zaelu/ZaeLinK/ZaeLinK description.md

# This is the Zaelink VR Gunstock

First pictures shows it in Quest 3 Configuration, Detachable Buttstock  and adjustable in length connecting rods (Olympic version). No Buttstock and Fixed Buttstock versions are also available (details bellow). 

### Left side view:

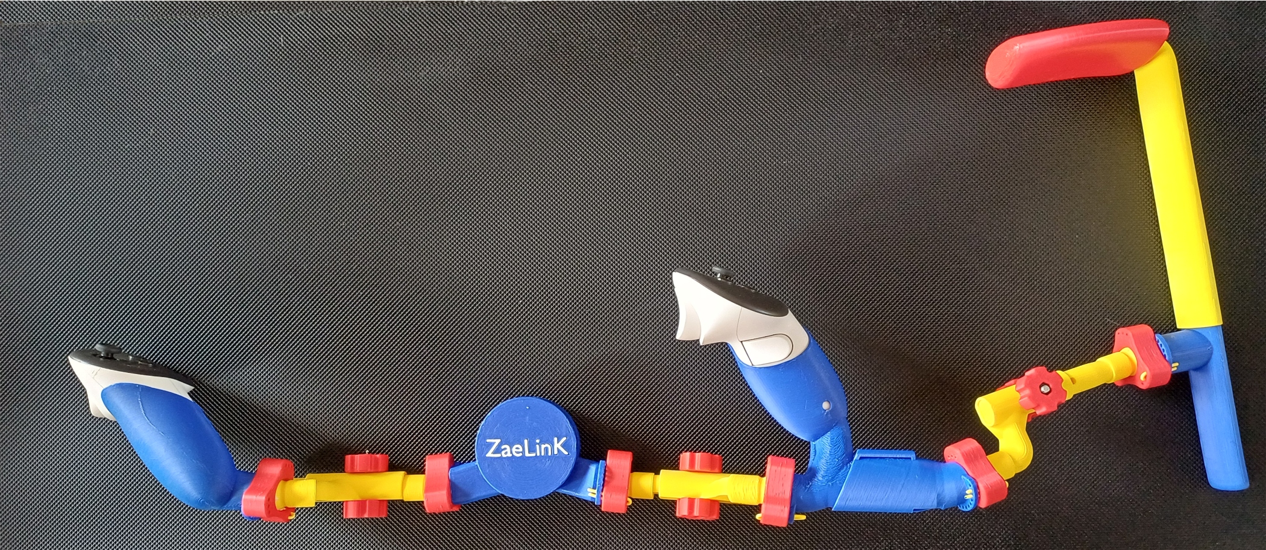
[picture p2: photos_docs/poza001.jpg]
Left side view


### Top down view:

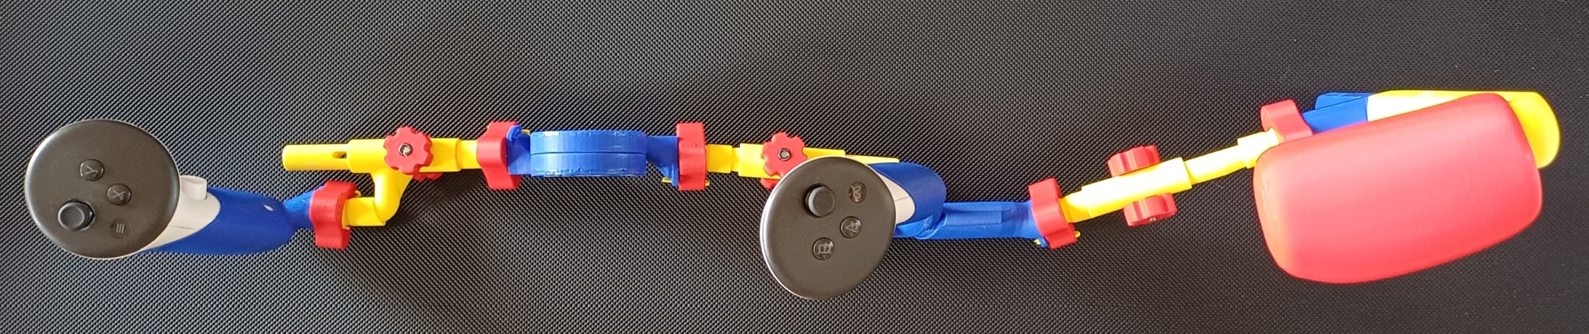
[picture p3: photos_docs/poza002.jpg]
Top down view


### Right side view:

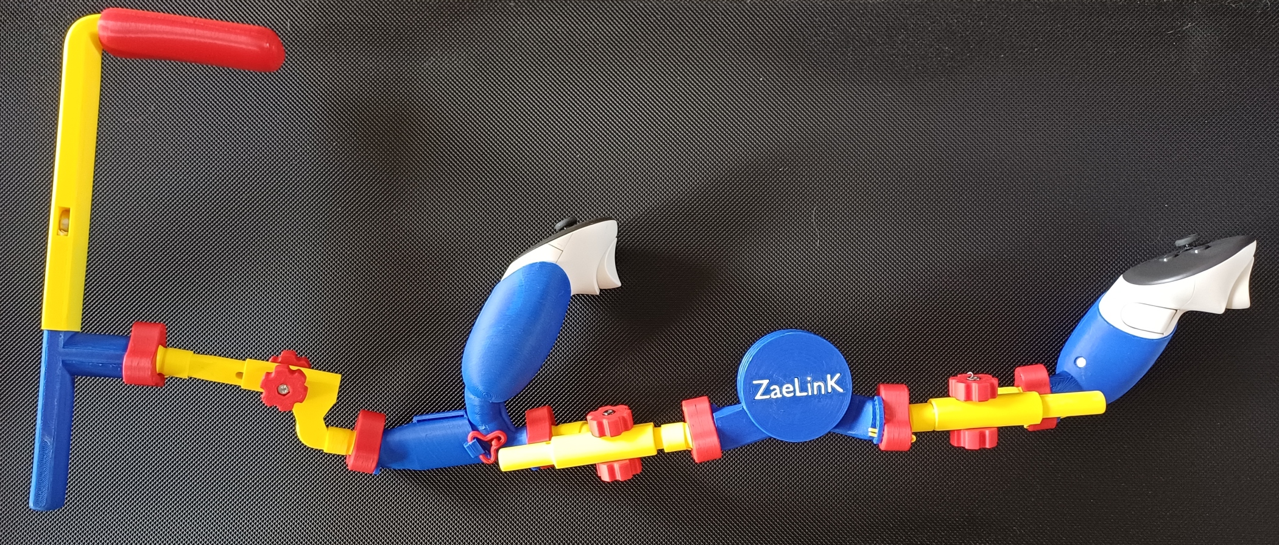
[picture p4: photos_docs/poza003.jpg]
Right side view

  
In this next two pictures we have the gunstock disassembled in its main component parts (NOTE that Quest 3s, Quest Pro and Quest 2 use the same cups as Quest 3) :  

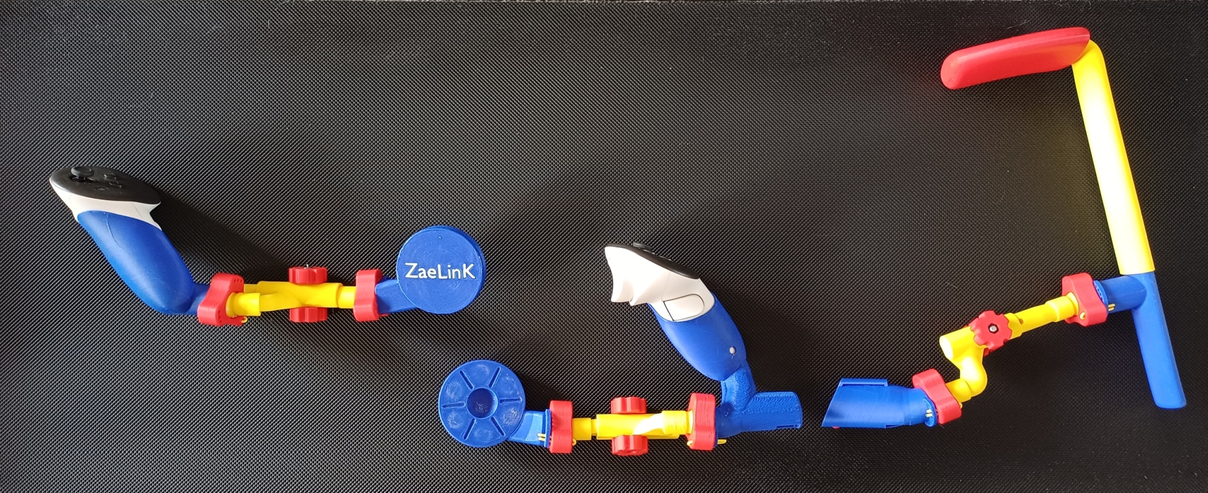
[picture p5: photos_docs/poza004.jpg]
main components


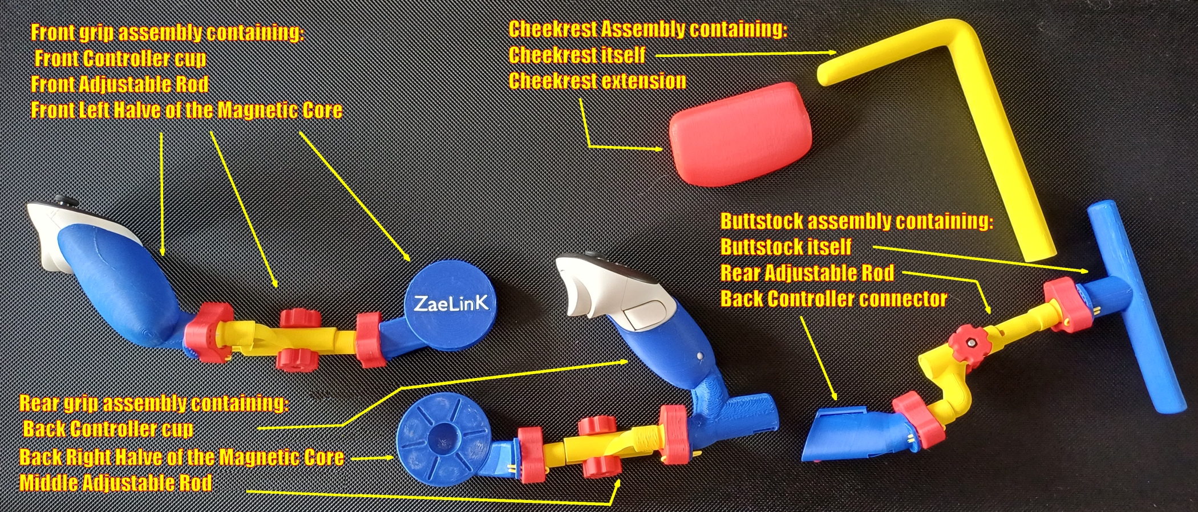
[picture p6: photos_docs/poza006.jpg]
main components2

  
The components of the Zaelink VR Gunstock are:  
  
**1** The main component is the **Magnetic Core** that effectively makes the connection between the two VR motion controllers user operates in realistic VR shooter type games or experiences.  

This Core is comprised of two round halves connected via connecting rods to the VR Touch Controllers. Inside the two circular halves that resembles to very flat cilinders facing each other vertically there are a pattern of (usually) 6 (six) button type magnets (15x6mm or smaller thickness for adjusting magnetic power) arranged in a hexagonal pattern where each center of every magnet finds itself on a corner of this hexagonal imaginary shape that defines its pattern. The distance between magnets can also be tweaked but the Zaelink VR Gunstock uses a fixed 5cm length for any hexagon edge as it was found to be optimal for this application.  
The two halves of the Magnetic Core thus attract each other by magnetic means while in close proximity aligning themselves with each of the six magnets of one side snapping to each of the six magnets of e other side. 

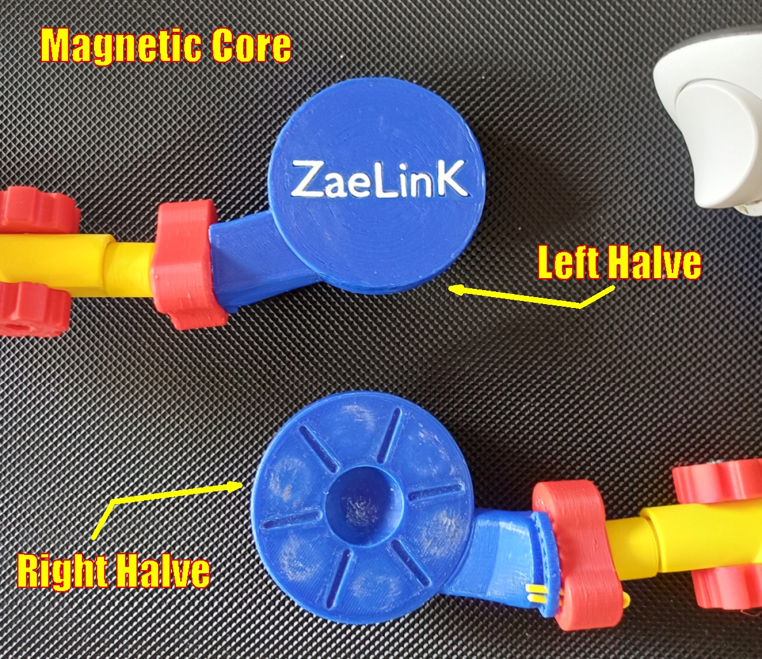
[picture p7: photos_docs/poza007.jpg]
Core pic 1


There are two principal patterns that are used:

 **FRAGNETTO**
 mode where 6 magnets on one side all aligned in polarity in same direction face the opposite polarity of the 6 magnets of the other side also all aligned in polarity in same direction as described also above. This pattern allows for strong attraction and auto orientation and alignment in most cases and also a good connection. After the connection was done the two halves can be rotated one in relation to the other by 60° steps at least twice in each direction (six steps in total for 360° but practically maximum 3 can be done before mechanical limits stop any rotation or force disconnection). After each rotation step the connection will stay ON being only weakened during translation. This weakening moment in translation is also a moment that can be exploited by the user to quickly disconnect the two halves by rotating them and as the rotation step is half way pulling the two halves apart. The disconnection can be done also by a more firm longitudinal twist and pull away. It also makes possible the disconnection in case of too much force pulling in wrong directions in case of accidents. This is part of self safety of the gunstock. Either the Core magnetic connection will fail or the adjustable ball socket joints will start to give before something breaks. Of course in extreme cases some parts can fail as they are made of plastic.

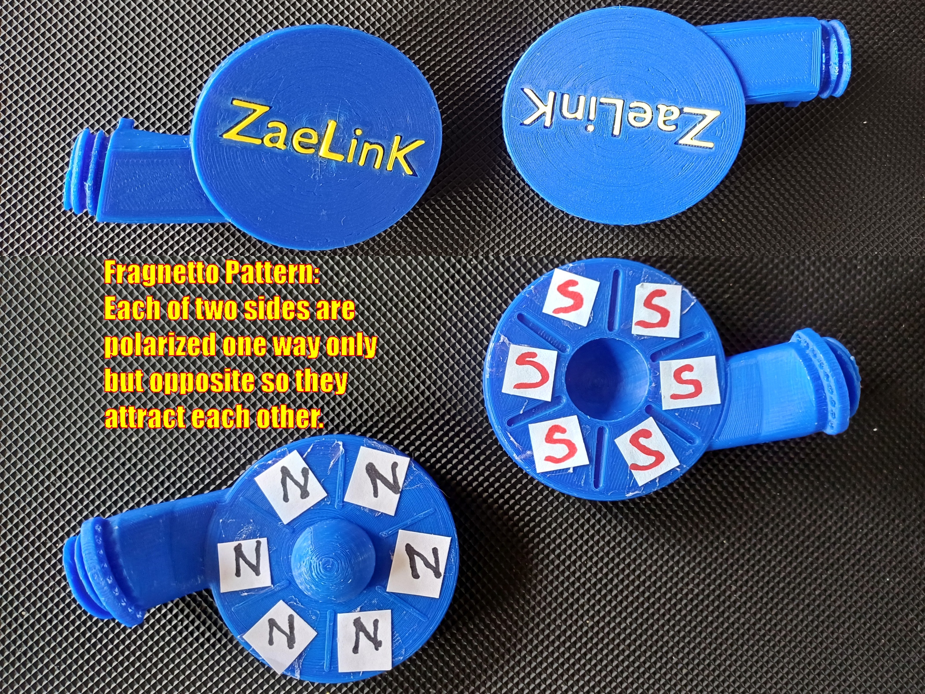
[picture p8: photos_docs/poza010.jpg]
Fragnetto pic


 **OLYMPIC**
 mode where 6 magnets of one side face only 4 magnets on the opposite side. The first halve with six magnets  has them aligned  3+3, meaning 3 consecutive magnets are magnetically aligned facing one direction and the other 3 (also consecutive) are magnetically aligned facing the opposite direction. I.E. If looking at one circular side of one halve we would have our pattern of 6 magnets 3 facing us with the North pole and 3 facing us with the South pole. The second halve has only 4 magnets placed in pairs separated by two empty corners of our hexagonal pattern. One pair of magnets is aligned while facing same direction among themselves with the opposite polarity of the magnets found on the opposite halve so they are attracted. The other pair, likewise, is aligned in reverse facing now the opposite side of the reversed polarity of the opposite 3 magnets on the opposite halve. Two (opposite) corners of the hexagonal pattern of this second halve are thus left empty As we can see in this configuration the attraction is mainly produced among 4 pairs of magnets as opposed of 6 in the other mode, however due to the empty places the attraction is cleaner and almost has the same power. However this type of connection has some potential advantages:

**1.** As we rotate through our steps as described above after a first step that might make the magnets jump from 4 pair magnet connection (attraction) to the second possible 4 pair magnet connection (attraction) the second step has only a 2 pair magnet attraction and 2 pair of magnet repulsion as now two of the pairs are facing each other with same polarity. At this moment the magnetic attraction between the two halves is practically zero and because of the way magnetism works in detail even a small repulsion is detected and this position facilitates a very fast disconnection between the two halves with minimum effort from the used**

**2. Using only 10 magnets instead of 12 weight and costs are saved.**

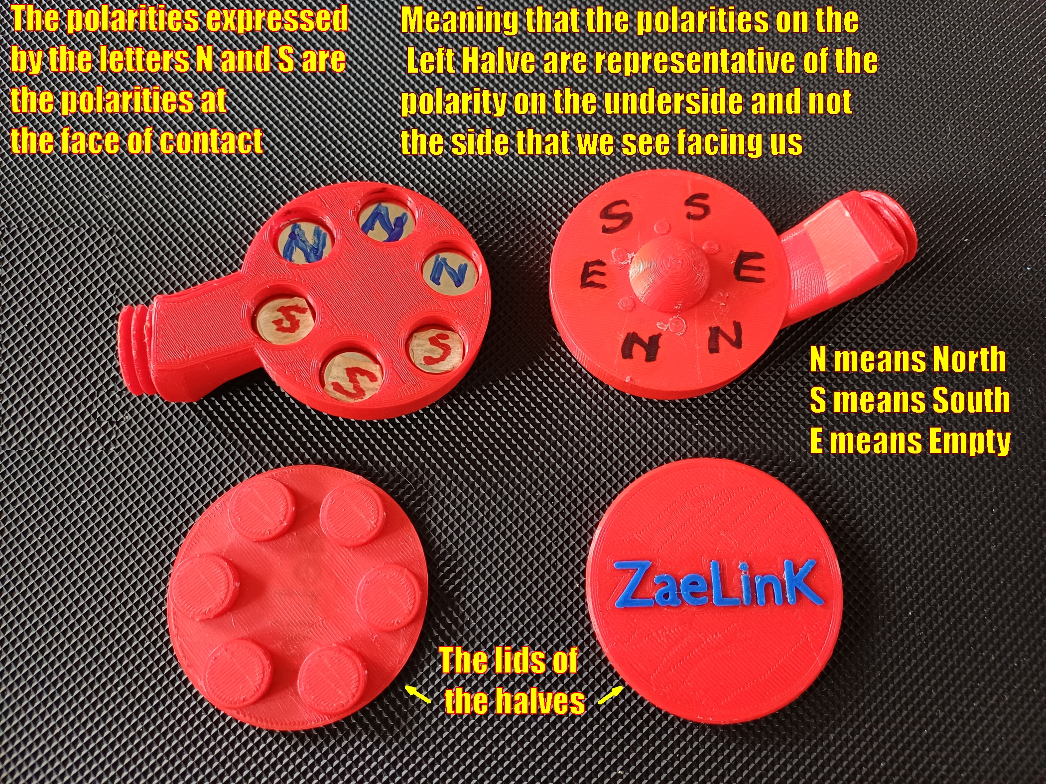
[picture p9: photos_docs/poza009.jpg]
Olympic pic
  

  The two halves rotate on a Pivot Pin or Gudgeon or Trunnion and its  Bore or Blind Hole or Socket type hole  that has the form of a cylinder with a hemisphere on top. The cylindric part allows rotation while the connection is established and the round hemisphere allows for easy slide in while the connection is being established and the two halves might not be completely aligned yet. When the connection is established this Pivot Pin and Bore assembly prevents the two halves from sliding over each other as the magnetic attraction between the pairs of magnets are not strong enough to block them from doing that during user operations. This way the connection between the two halves is strong and stable by both means of magnetism and mechanical resistance. 

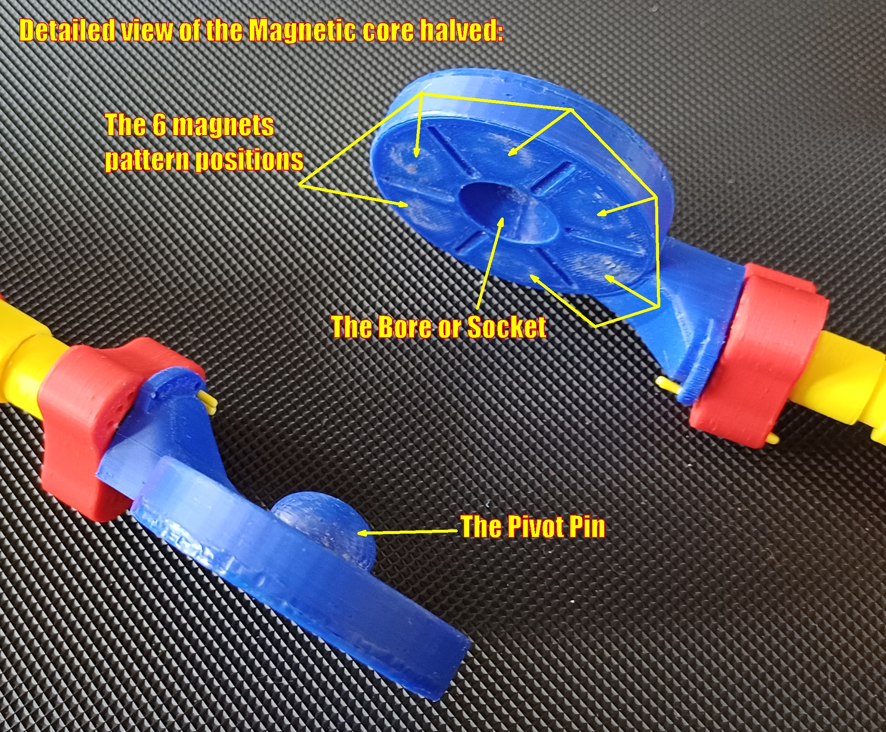
[picture p10: photos_docs/poza008.jpg]
pivot view


  **2.** The second component is **the pair of Two Cups** that hold the actual VR Touch Controllers in the case of modern VR heassets like Meta Quest 3, 3S and Pro (Quest 2 works with same cups as 3), Pico 4 Ultra and in the short future Steam Frame controllers. For Pico 4 non Ultra the controllers instead of cups under rings clamps are used to latch on the controllers spiral rings from underneath avoiding occlusion of the IR tracking LEDs

The cups are designed such the controllers can slide in with ease and also mechanically be retained inside them requiring a minimal force to pull them off. Also they are designed to be 3D printed in such direction that the cups and their attachments that permit the coupling to the connecting rods that link them to the magnetic core and the buttstock are very strong and resist to operating tensions due to how the layer lines pass during printing. The same 3D printing design measures ensures a good shape of these cups that allow them to be thin (only 1-1.5mm thick) and offer good grip cvasi identical with original to the user.

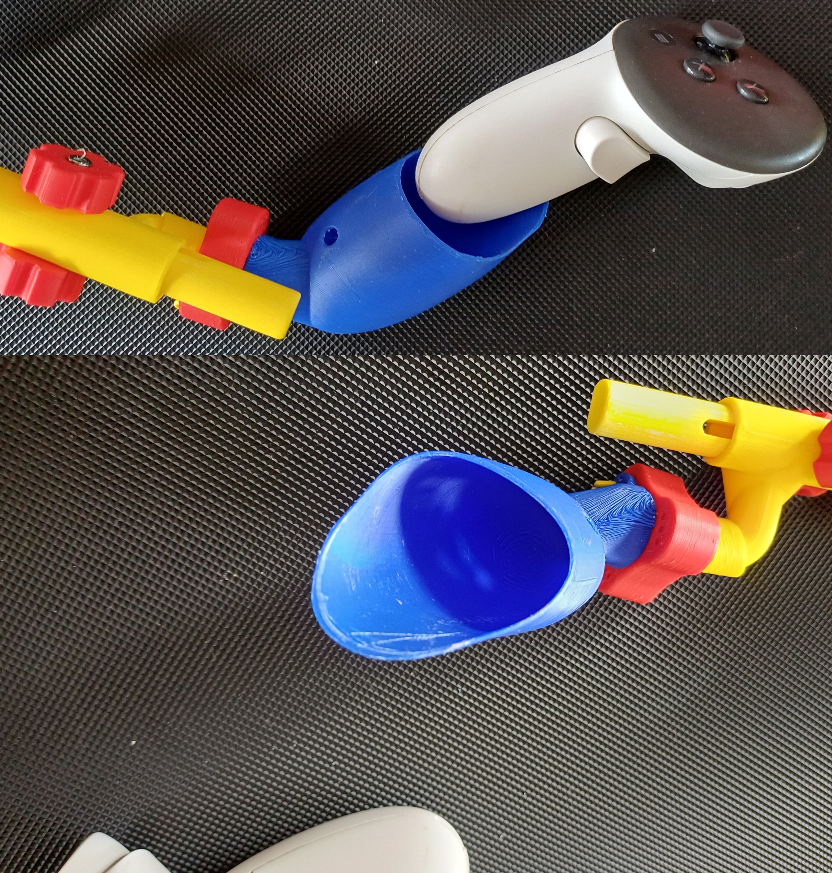
[picture p11: photos_docs/poza011.jpg]
cups view

  
  **3.** The third component is the **modular Buttstock** that allows shoulder contact while having a wide range of adaptability and customisation. It’s position can be adjusted in several ways by its *Extendable rod* the length can be controlled, by its *Ball Socket joints* its position can be tweaked laterally and vertically, by *Rotation of the extendable rod* its lateral position can be further amplified. The buttstock is modular and has an attachable **Cheekrest** that offers a forth point of contact on the cheek while operating the gunstock. Further more the Cheekrest has possibility of attachment of a **Cheekrest Extension** that can modify the lateral position where the Cheekrest contacts the face of the user.

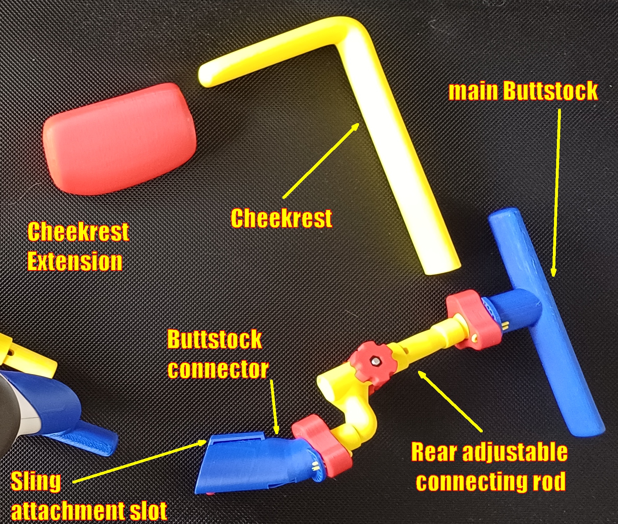
[picture p12: photos_docs/poza012.jpg]
Buttstock view


A detail picture with Buttstock showing the opposite side where the magnets are slotted in it and Cheekrest for a stronger connection 

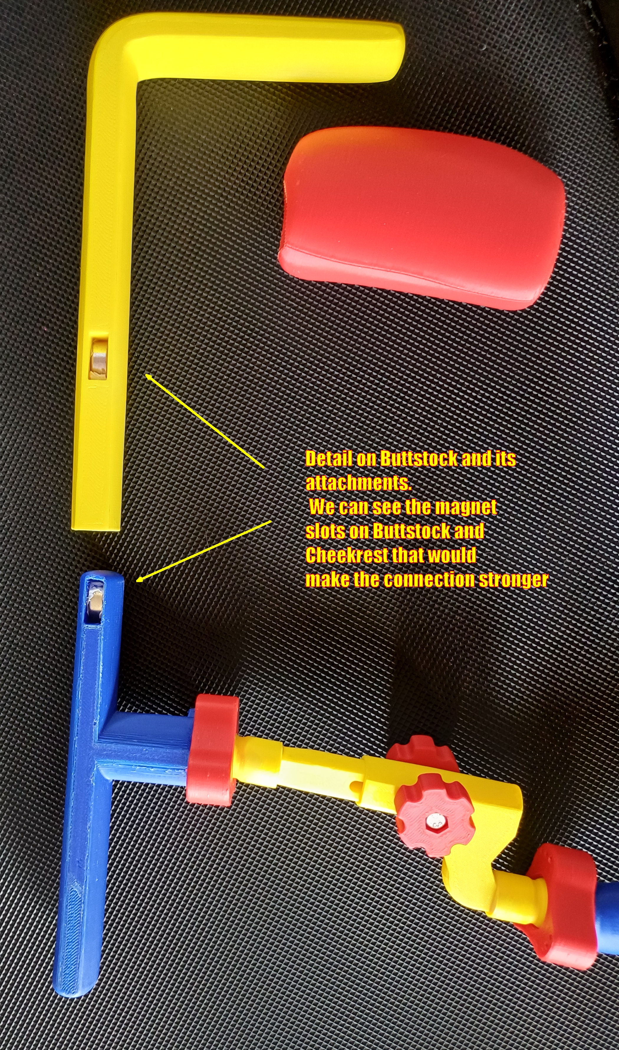
[picture p13: photos_docs/poza013.jpg]
buttstock 2nd view


Another detail picture on Buttstock shows its connector for the detachable variant. A variant non detachable also exists and likewise a variant where no buttstock connection exists for people that want no buttstock at all.

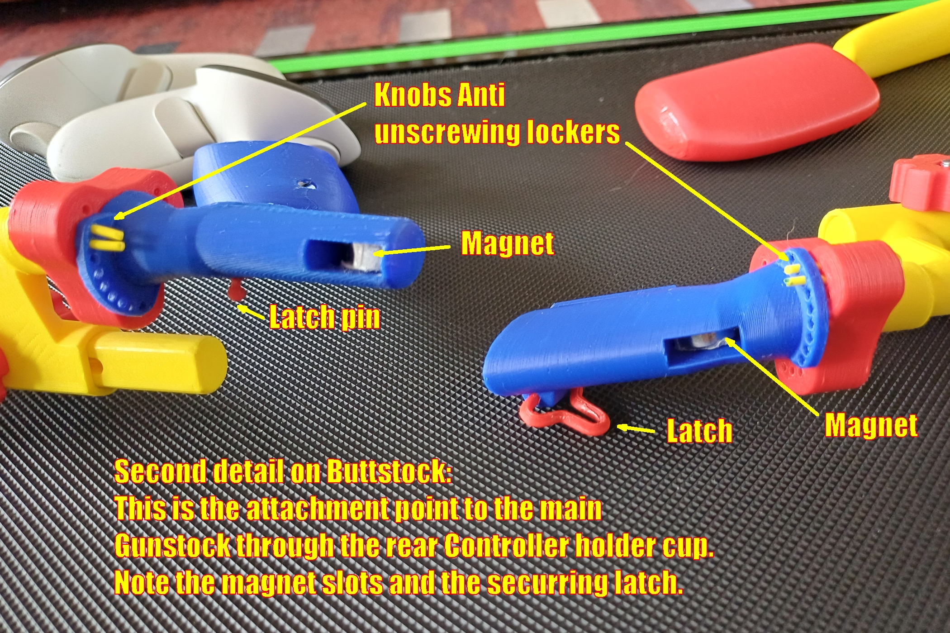
[picture p14: photos_docs/poza014.jpg]
buttstock 3rd view


Here bellow you can see a non detachable Buttstock variant that also has non adjustable connecting rods. Their length can be chosen or modified prior to printing. 

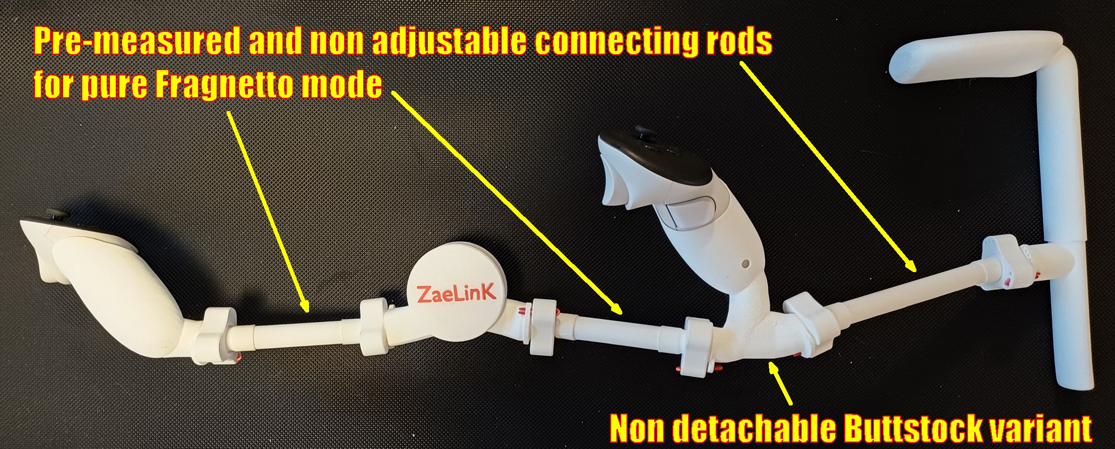
[picture p15: photos_docs/poza015.jpg]
white gunstock non detach view


**4.** The fourth component is comprised of the 3 extendable or fixed in length connecting rods. These connecting rods make the connection between the first three components. There design, 3d printing details and operation are critical to the use of the Zaelink gunstock.

  Two type are thus provided for maximum of flexibility. The fixed ones trade the variable length for lightness and ruggedness while the extendable ones offer maximum convenience. The extendable ones are associated mostly with the Olympic mode while the fixed ones more with Fragnetto mode But this is just a paradigm alignment mostly as mixes are totally possible including having some connecting rods fixed and some extendable. 

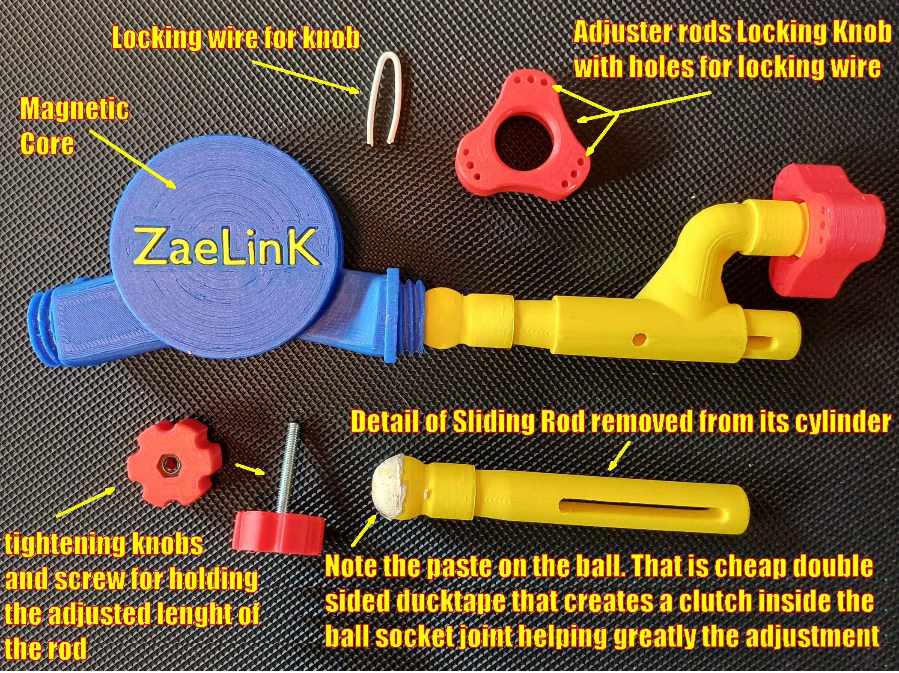
[picture p16: photos_docs/poza016.jpg]
connecting rods 1st view


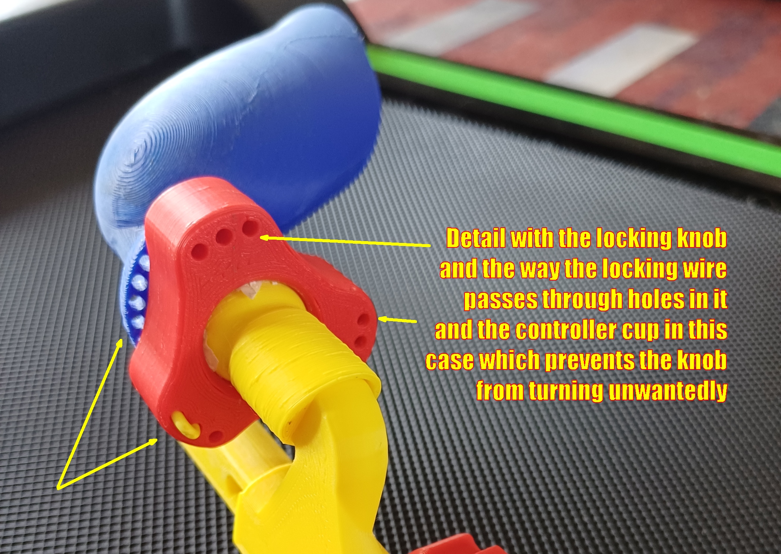
[picture p17: photos_docs/poza017.jpg]
connecting rods 2nd view


Finally 3 more pictures with some more details. First show the adjusting rods in extended position. Second and Third show a Pico 4 Ultra and respectively a Pico 4 (nonUltra) variants in Fragnetto Configuration with fixed connecting rods.

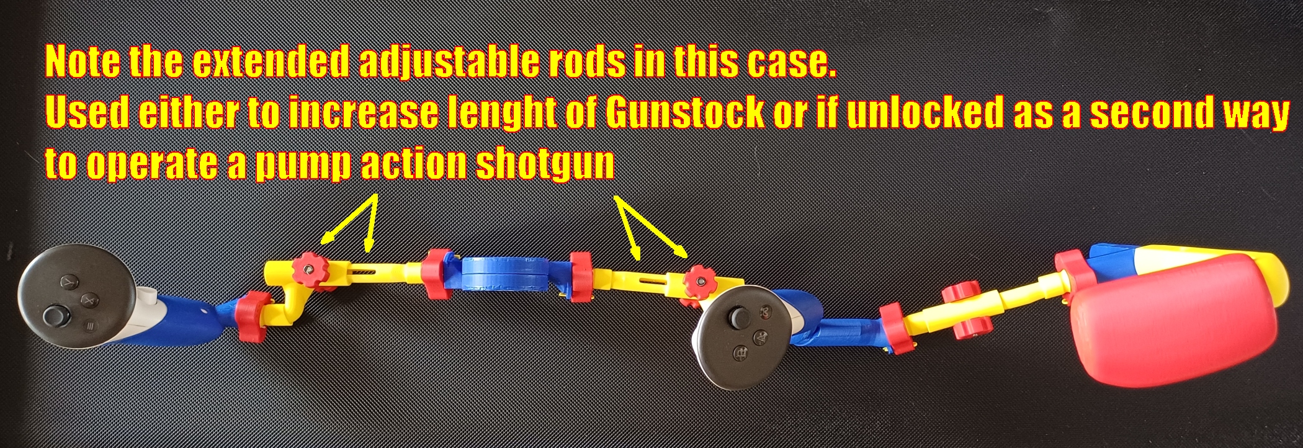
[picture p18: photos_docs/poza018.jpg]
extended rods


**Pico 4 Ultra version with fixed connecting rods**

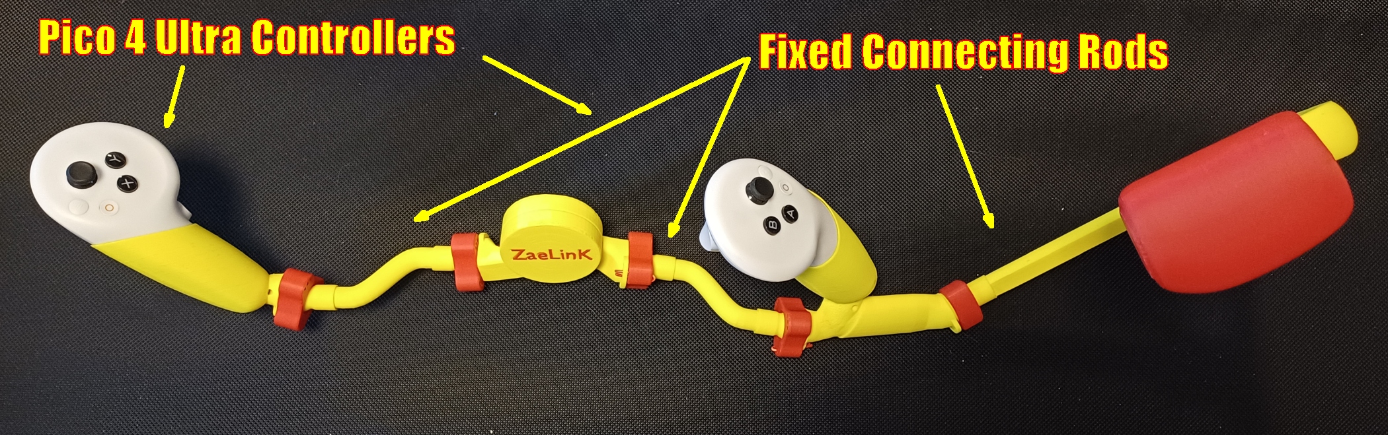
[picture p19: photos_docs/poza019.jpg]
P4U


**Pico 4 non Ultra version sporting stronger knobs for rare cases of 3d printing defects.**

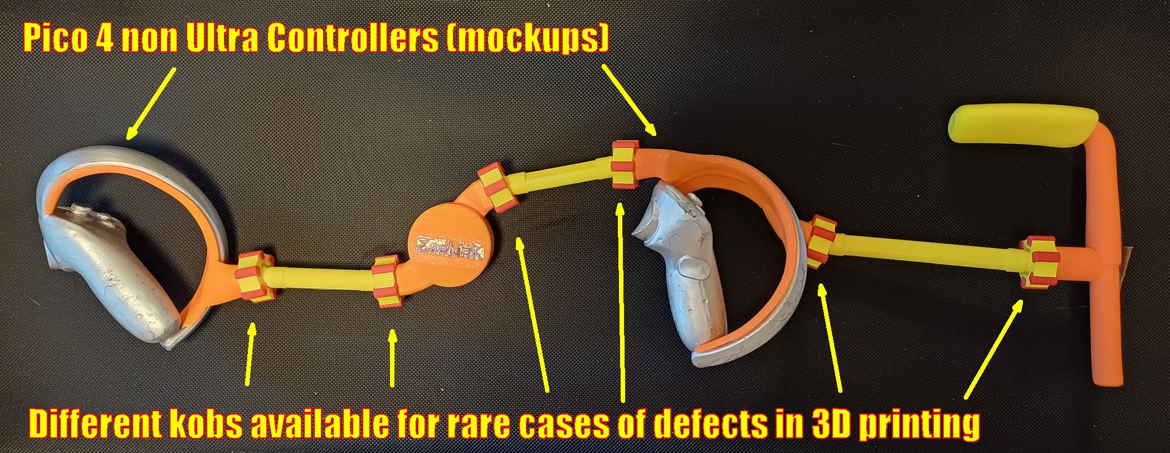
[picture p20: photos_docs/poza020.jpg]
P4nonU


**End of document.**
