zaelu/ZaeLinK/ZaeLinK STL files/Connecting Rods/Zaelink Adjustable Rod Main 166.stl

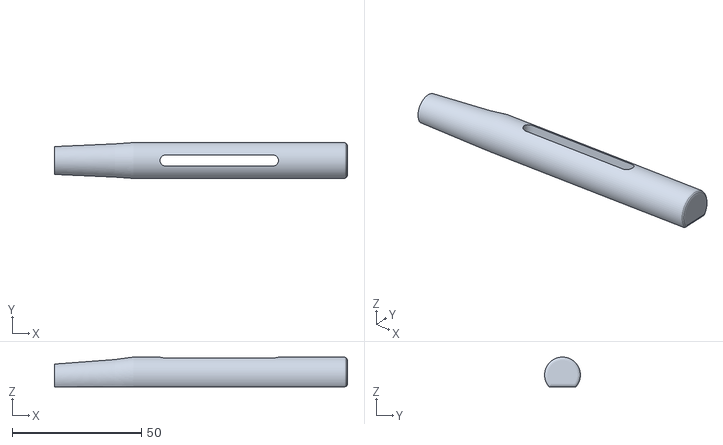
[picture p21: CAD file, 2026-10-12]
ZaeLinK STL files/Connecting Rods/Zaelink Adjustable Rod Main 166.stl
113.5 x 13.9 x 11.6
