zaelu/ZaeLinK/ZaeLinK STL files/Buttstock/Left Handed/Zaelink Cheekrest LH 166.stl

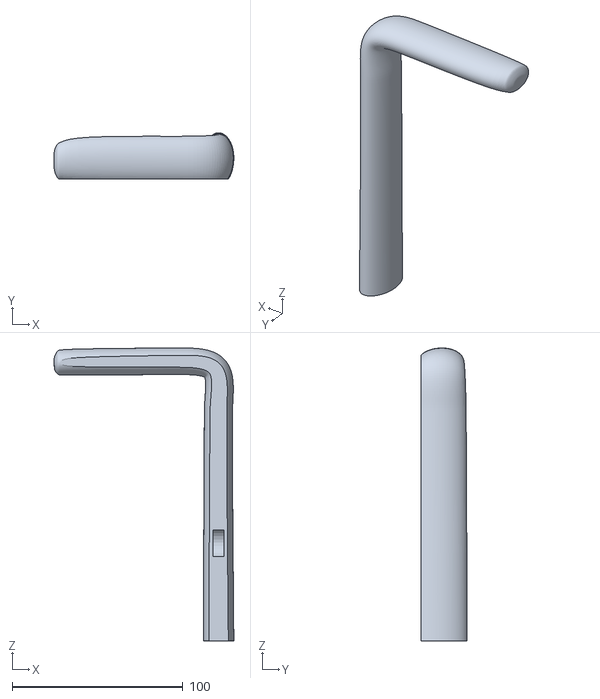
[picture p22: CAD file, 2026-10-12]
ZaeLinK STL files/Buttstock/Left Handed/Zaelink Cheekrest LH 166.stl
105.3 x 27.2 x 171.7
