zaelu/ZaeLinK/ZaeLinK STL files/Buttstock/Right Handed/Zaelink Cheekrest Extension RH 166.stl

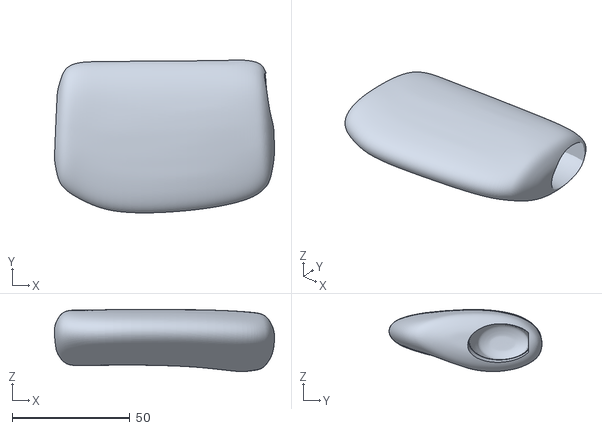
[picture p23: CAD file, 2026-10-12]
ZaeLinK STL files/Buttstock/Right Handed/Zaelink Cheekrest Extension RH 166.stl
93.3 x 64.8 x 26.3
