zaelu/ZaeLinK/ZaeLinK STL files/Connecting Rods/Zaelink NON Adjustable Rod Straight 166.stl

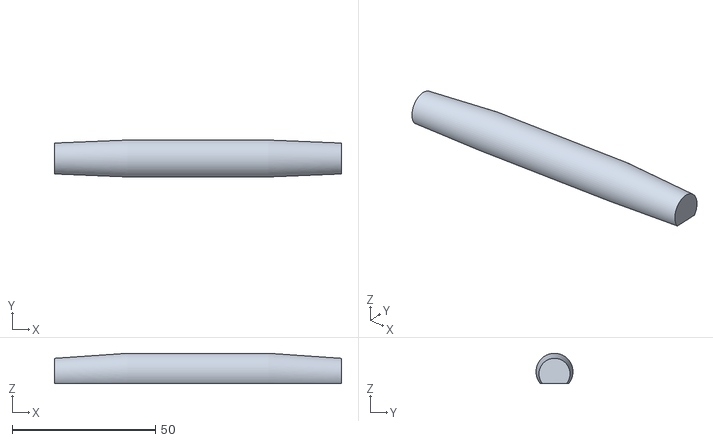
[picture p24: CAD file, 2026-10-12]
ZaeLinK STL files/Connecting Rods/Zaelink NON Adjustable Rod Straight 166.stl
100.1 x 12.9 x 10.6
