zaelu/ZaeLinK/ZaeLinK STL files/Magnetic Core Connector/Left Handed/Zaelink Magnetic Core Left Halve LH 166.stl

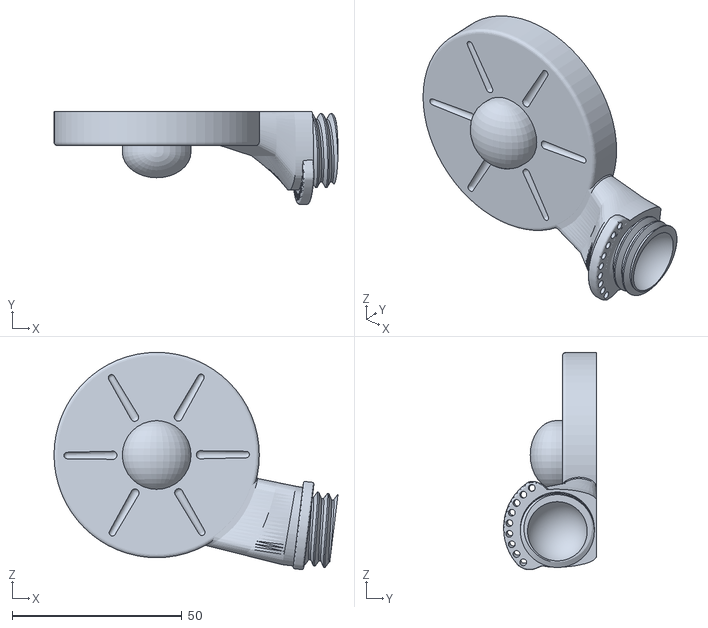
[picture p25: CAD file, 2026-10-12]
ZaeLinK STL files/Magnetic Core Connector/Left Handed/Zaelink Magnetic Core Left Halve LH 166.stl
83.6 x 27.3 x 64.0
