zaelu/ZaeLinK/ZaeLinK STL files/Magnetic Core Connector/Right Handed/Zaelink Magnetic Core Left Halve RH 166.stl

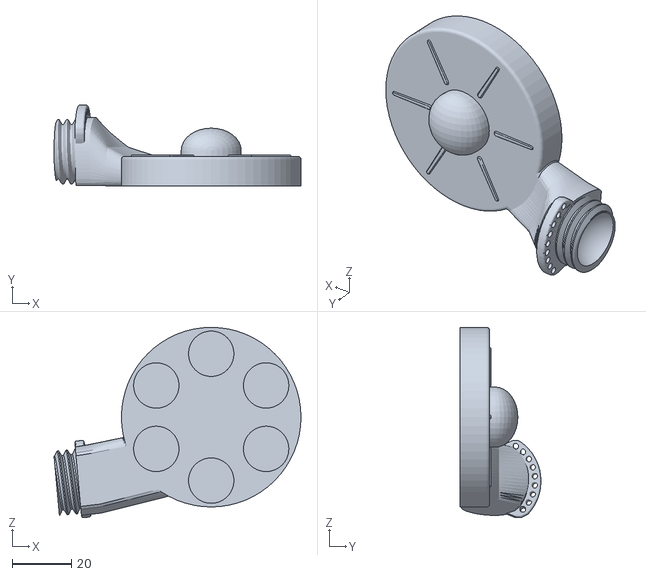
[picture p26: CAD file, 2026-10-12]
ZaeLinK STL files/Magnetic Core Connector/Right Handed/Zaelink Magnetic Core Left Halve RH 166.stl
83.2 x 27.3 x 64.1
