zaelu/ZaeLinK/ZaeLinK STL files/Pico 4 Handles beta RH only/Right Handed/Zaelink P4 Left Front Handle RH Beta.166.stl

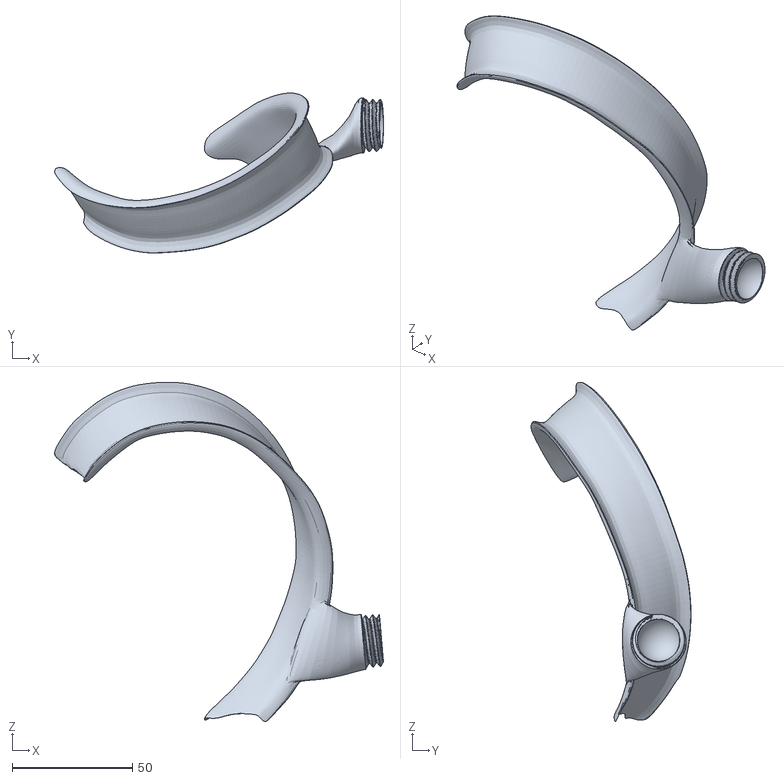
[picture p27: CAD file, 2026-10-12]
ZaeLinK STL files/Pico 4 Handles beta RH only/Right Handed/Zaelink P4 Left Front Handle RH Beta.166.stl
136.7 x 66.5 x 141.0
