zaelu/ZaeLinK/ZaeLinK STL files/Pico 4 Ultra Handles/Left Handed/Zaelink P4U Left Back Handle NON Detachable Butstock LH 166.stl

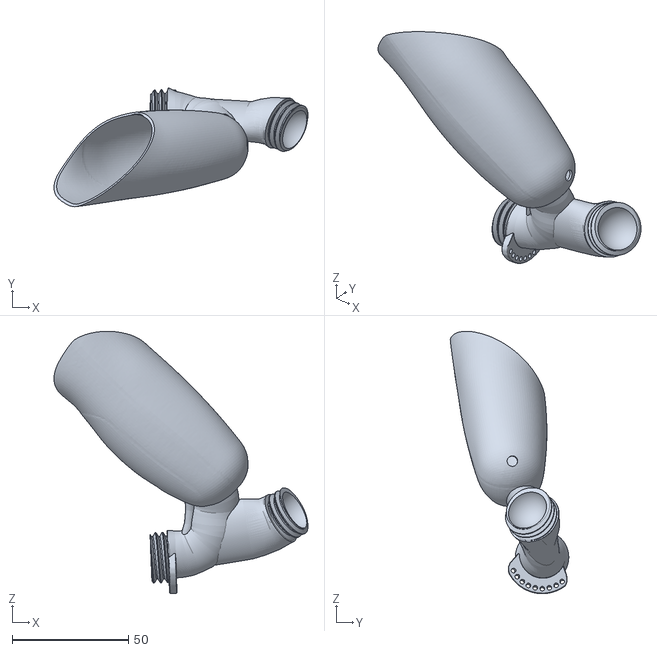
[picture p28: CAD file, 2026-10-12]
ZaeLinK STL files/Pico 4 Ultra Handles/Left Handed/Zaelink P4U Left Back Handle NON Detachable Butstock LH 166.stl
109.3 x 51.0 x 112.9
