zaelu/ZaeLinK/ZaeLinK STL files/Quest (all) Handles/Left Handed/Zaelink Q3 Left Back Handle Detachable Butstock LH 166.stl

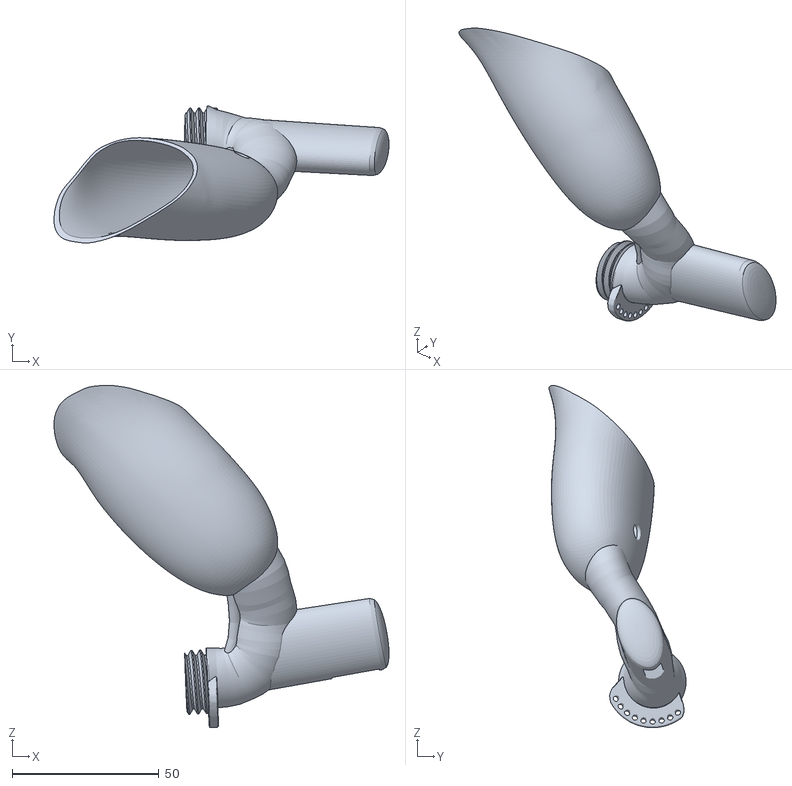
[picture p29: CAD file, 2026-10-12]
ZaeLinK STL files/Quest (all) Handles/Left Handed/Zaelink Q3 Left Back Handle Detachable Butstock LH 166.stl
114.1 x 46.7 x 116.6
