zaelu/ZaeLinK/ZaeLinK STL files/Quest (all) Handles/Right Handed/Zaelink Q3 Left Front Handle RH 166.stl

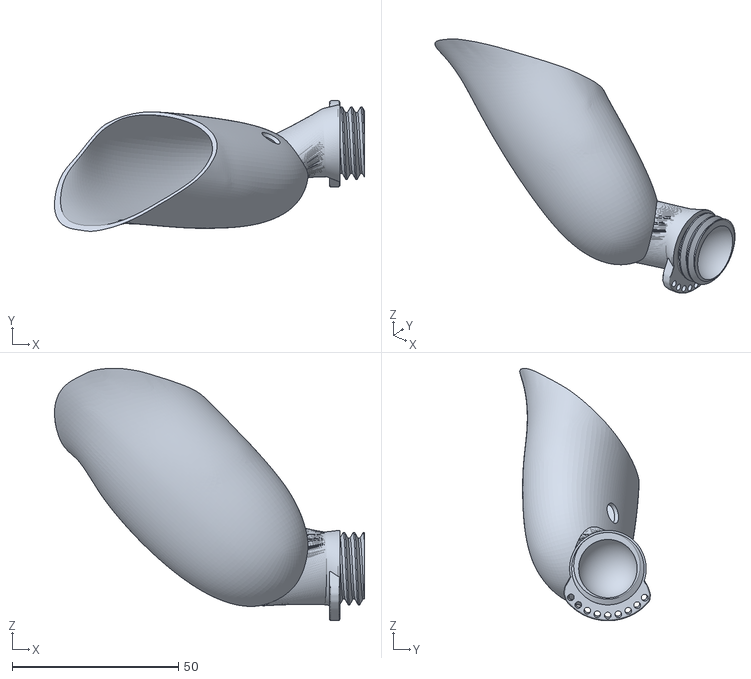
[picture p30: CAD file, 2026-10-12]
ZaeLinK STL files/Quest (all) Handles/Right Handed/Zaelink Q3 Left Front Handle RH 166.stl
93.2 x 39.3 x 75.9
