zaelu/ZaeLinK/ZaeLinK STL files/Buttstock/Left Handed/Zaelink Butstock to Cup Connector LH 166.stl

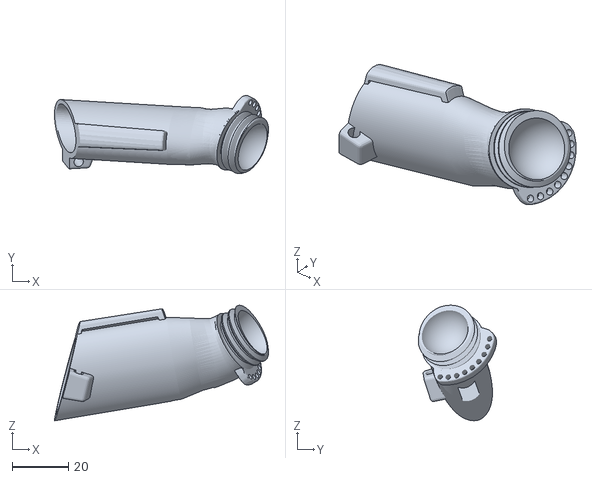
[picture p31: CAD file, 2026-10-12]
ZaeLinK STL files/Buttstock/Left Handed/Zaelink Butstock to Cup Connector LH 166.stl
76.0 x 27.9 x 41.0
