zaelu/ZaeLinK/ZaeLinK STL files/Pico 4 Handles beta RH only/Right Handed/Zaelink P4 Right Back Handle RH Beta.166.stl

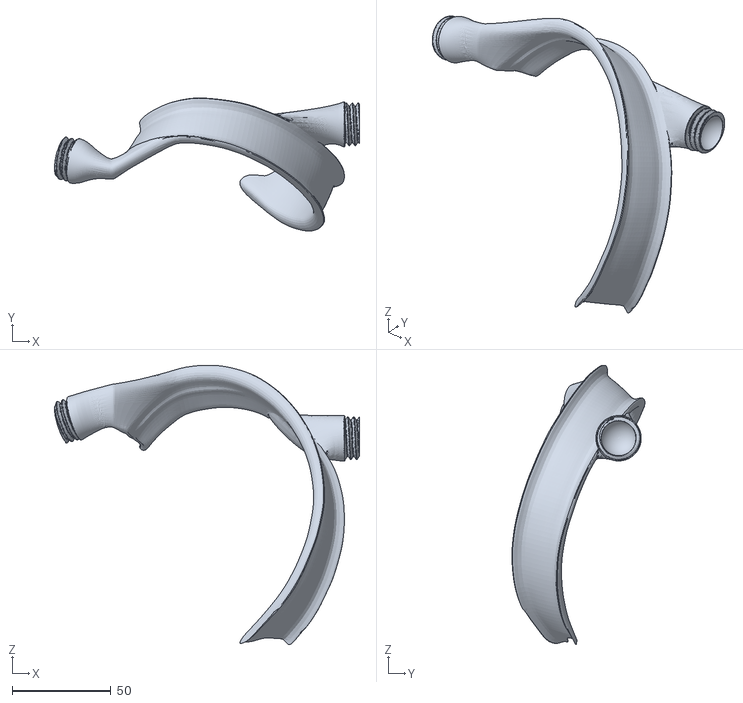
[picture p32: CAD file, 2026-10-12]
ZaeLinK STL files/Pico 4 Handles beta RH only/Right Handed/Zaelink P4 Right Back Handle RH Beta.166.stl
154.1 x 67.3 x 141.2
