zaelu/ZaeLinK/ZaeLinK STL files/Buttstock/Left Handed/Zaelink Butstock LH 166.stl

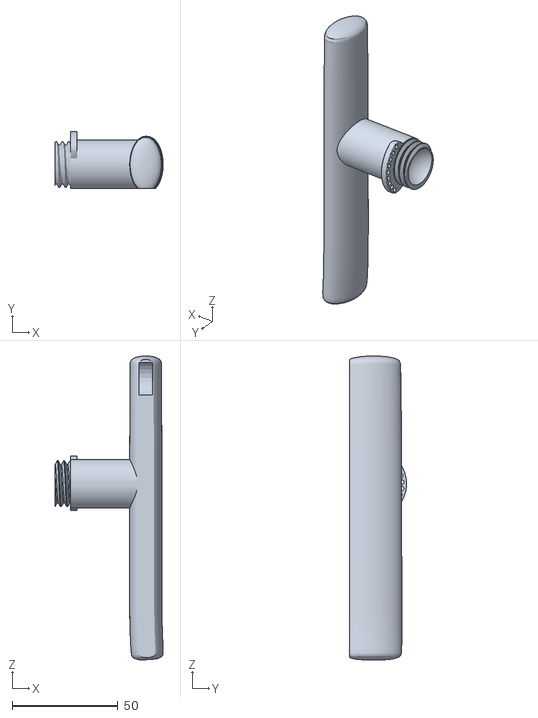
[picture p34: CAD file, 2026-10-12]
ZaeLinK STL files/Buttstock/Left Handed/Zaelink Butstock LH 166.stl
51.3 x 27.0 x 143.7
