zaelu/ZaeLinK/ZaeLinK STL files/Connecting Rods/Zaelink NON Adjustable Rod bent to be mirrored when needed 166.stl

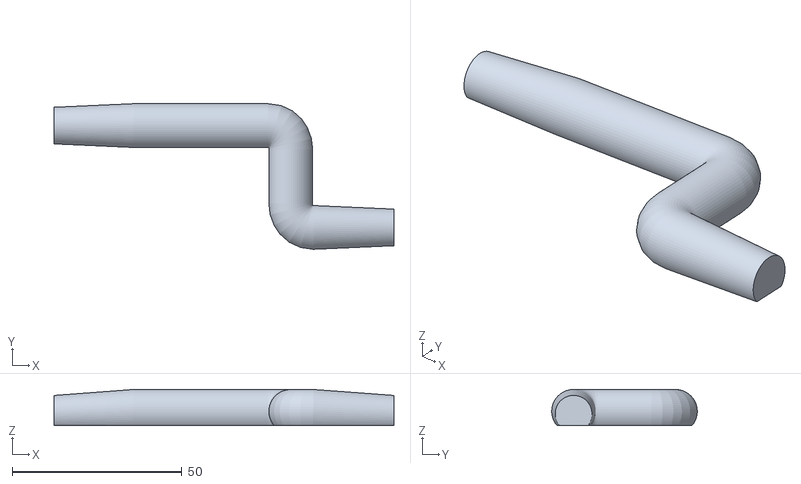
[picture p35: CAD file, 2026-10-12]
ZaeLinK STL files/Connecting Rods/Zaelink NON Adjustable Rod bent to be mirrored when needed 166.stl
100.1 x 42.9 x 10.6
