zaelu/ZaeLinK/ZaeLinK STL files/Magnetic Core Connector/Left Handed/Zaelink Magnetic Core Lid 166.stl

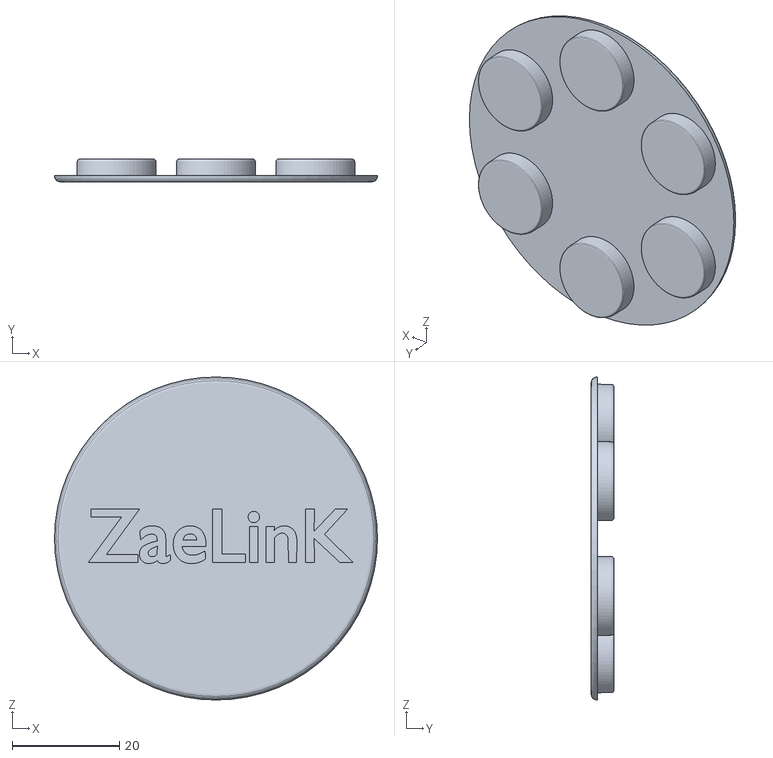
[picture p36: CAD file, 2026-10-12]
ZaeLinK STL files/Magnetic Core Connector/Left Handed/Zaelink Magnetic Core Lid 166.stl
60.1 x 4.25 x 60.1
