zaelu/ZaeLinK/ZaeLinK STL files/Pico 4 Ultra Handles/Left Handed/Zaelink P4U Right Front Handle LH 166.stl

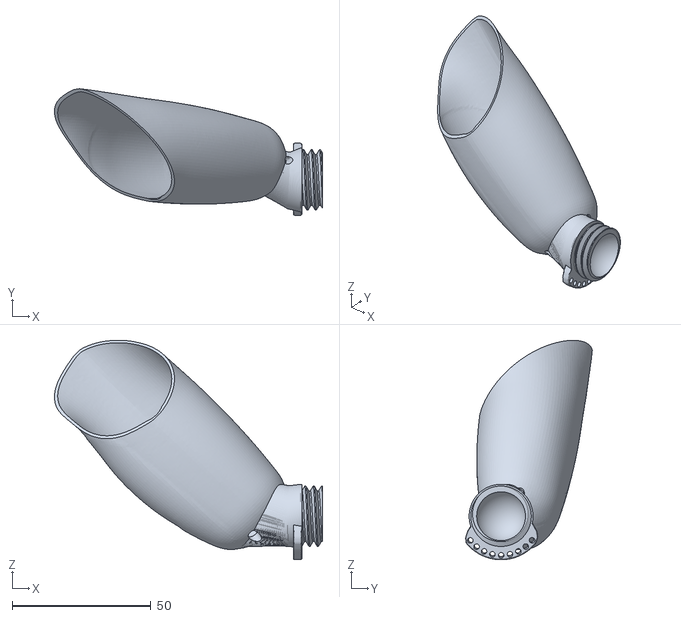
[picture p37: CAD file, 2026-10-12]
ZaeLinK STL files/Pico 4 Ultra Handles/Left Handed/Zaelink P4U Right Front Handle LH 166.stl
96.5 x 45.6 x 79.0
