zaelu/ZaeLinK/ZaeLinK STL files/Pico 4 Ultra Handles/Right Handed/Zaelink P4U Right Back Handle NO Butstock RH 166.stl

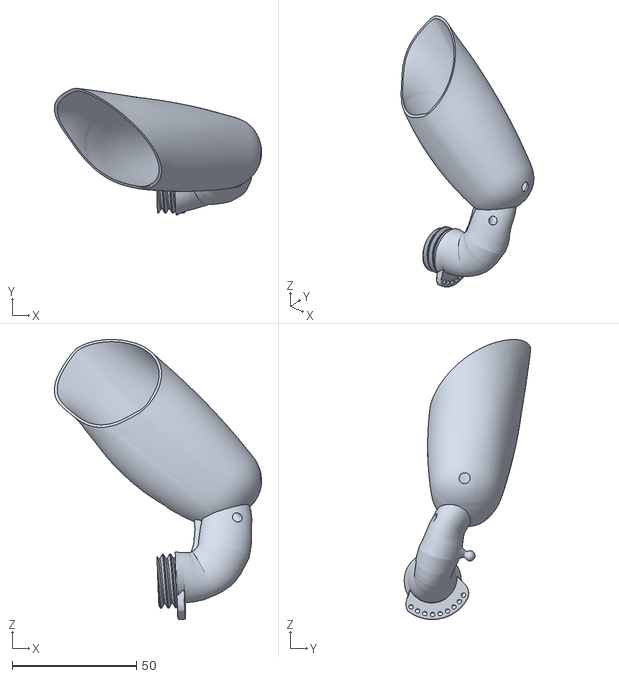
[picture p38: CAD file, 2026-10-12]
ZaeLinK STL files/Pico 4 Ultra Handles/Right Handed/Zaelink P4U Right Back Handle NO Butstock RH 166.stl
83.5 x 51.0 x 112.9
