zaelu/ZaeLinK/ZaeLinK STL files/Connecting Rods/Zaelink Adjustable Rod Cylinder to be mirrored when needed 166.stl

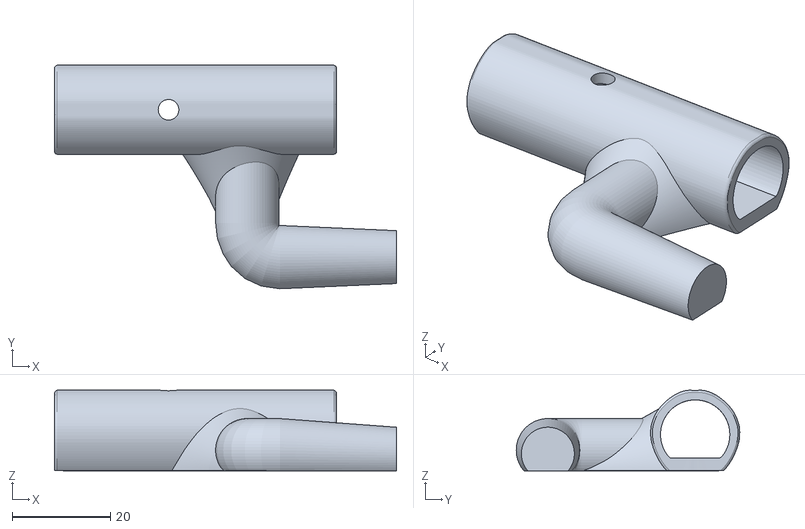
[picture p39: CAD file, 2026-10-12]
ZaeLinK STL files/Connecting Rods/Zaelink Adjustable Rod Cylinder to be mirrored when needed 166.stl
69.7 x 45.5 x 16.4
