zaelu/ZaeLinK/ZaeLinK STL files/Connecting Rods/Zaelink Ball to be mirrored when needed 166.stl

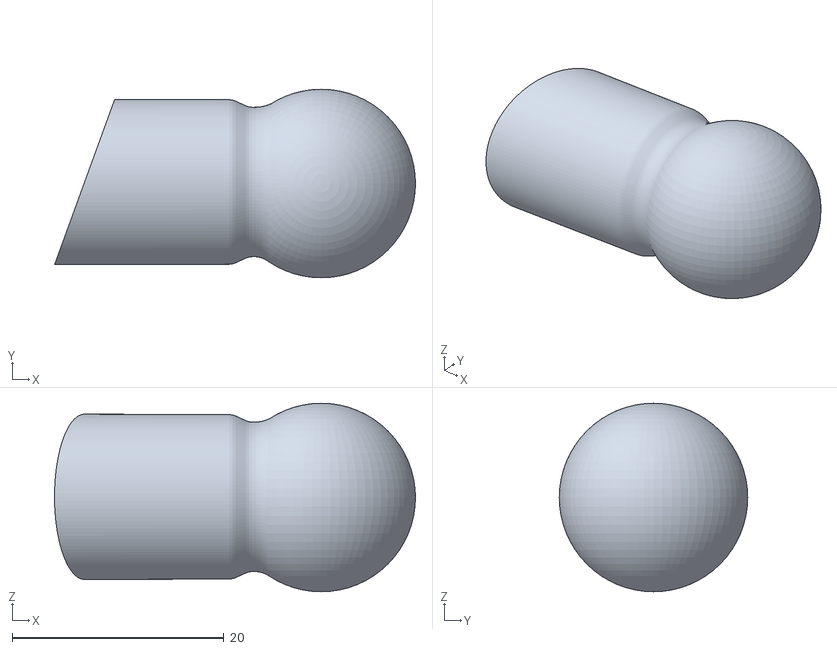
[picture p40: CAD file, 2026-10-12]
ZaeLinK STL files/Connecting Rods/Zaelink Ball to be mirrored when needed 166.stl
34.1 x 17.8 x 17.8
