zaelu/ZaeLinK/(list of files, cad)

Other CAD files:
ZaeLinK STL files/Pico 4 Ultra Handles/Right Handed/Zaelink P4U Right Back Handle NON Detachable Butstock RH 166.stl
ZaeLinK STL files/Buttstock/Right Handed/Zaelink Cheekrest RH 166.stl
ZaeLinK STL files/Magnetic Core Connector/Left Handed/Zaelink Magnetic Core Right Halve LH 166.stl
ZaeLinK STL files/Magnetic Core Connector/Right Handed/Zaelink Magnetic Core Right Halve RH 166.stl
ZaeLinK STL files/Pico 4 Ultra Handles/Left Handed/Zaelink P4U Left Back Handle Detachable Butstock LH 166.stl
ZaeLinK STL files/Pico 4 Ultra Handles/Right Handed/Zaelink P4U Right Back Handle Detachable Butstock RH 166.stl
ZaeLinK STL files/Quest (all) Handles/Right Handed/Zaelink Q3 Right Back Handle Detachable Butstock RH 166.stl
ZaeLinK STL files/Buttstock/Right Handed/Zaelink Butstock to Cup Connector RH 166.stl
ZaeLinK STL files/Quest (all) Handles/Left Handed/Zaelink Q3 Left Back Handle NON Detachable Butstock LH 166.stl
ZaeLinK STL files/Quest (all) Handles/Right Handed/Zaelink Q3 Right Back Handle NON Detachable Butstock RH 166.stl
ZaeLinK STL files/Buttstock/Left Handed/Zaelink Cheekrest Extension LH 166.stl
ZaeLinK STL files/Buttstock/Right Handed/Zaelink Butstock RH 166.stl
ZaeLinK STL files/Pico 4 Ultra Handles/Left Handed/Zaelink P4U Left Back Handle NO Butstock LH 166.stl
ZaeLinK STL files/Pico 4 Ultra Handles/Right Handed/Zaelink P4U Left Front Handle RH 166.stl
ZaeLinK STL files/Quest (all) Handles/Left Handed/Zaelink Q3 Right Front Handle LH 166.stl
ZaeLinK STL files/Quest (all) Handles/Right Handed/Zaelink Q3 Right Back Handle NO Butstock RH 166.stl
ZaeLinK STL files/Connecting Rods/Zaelink Locking Nut 6 needed 166.stl
