zaelu/ZaeLinK/Zaelink How to Build One.md

### This is how you can build your own Zaelink VR Gunstock step by step

to be continued
