zaelu/ZaeLinK/Zaelink design features and history.md

## Zaelink Design

### How Zaelink came to be and a detailed description of its design functionality wise and also manufacturing wise

**To be added**
